MohanSai110/Multi-output-flyback-converter/README.md

# Multi-output-flyback-converter
design ,simulating and analysis of multi output flyback converter
