MohanSai110/Multi-output-flyback-converter/Final_flyback_completedesign_openloop.pdf

### Complete Design &Derivation — 150WOpen-Loop Multi-OutputFlybackConverter

12V/100W+ 5V/50W, DCM, single fixedline (230Vac mains)

Thisdocumentderiveseveryelementfromthe specificationforward,withthe reasoningat eachstep. Numbershere are thefinal, converged, self-consistent designpoint— reconcilingthe iterative refinementdone across simulation.

### 0. Specifications and starting assumptions

Parameter | Value | Basis
Output 1 | 12V, 100W(8.33A) | Given spec
Output 2 | 5V,50W(10A) | Given spec
Total Pout | 150W | Sum
Mains | 230Vac ±10%, 50Hz, | Realintendedtest condition(notuniversalinput)
| single fixed line
Operating bus | 325V (=230×√2) | Rectified peak, no-ripple idealization for the design point
Vin
Stress-rating | 90–375V | Retainedonly for component voltage margin, not for
bus range | | operatingduty —protects against line variation/spikes
| | eventhoughonlyoneline is tested
Switching | 65kHz (Ts=15.385µs) Design choice, reasonable for this power/size class
frequencyfs
Target efficiency η | ≈85–88% | Typical for a multi-output flyback this size; confirmed
| | ≈88.6%fromsimulation

1.Input stage derivation

Bridgerectifier: must handle input RMS current with margin. Estimate Iin,rms ≈ Pin/(Vac × PF); withnoPFC, PFispoor (~0.5–0.6typicalfor a capacitor-input rectifier), givingIin,rms ≈ 176.5/(230 × 0.55) ≈ 1.4Aaverage-equivalent, but peakcharging currentismuchhigher (bulkcapchargesonlynear theACpeak). Select≥4Acontinuous, 600Vrated(e.g. GBU4K) —the voltage ratingcovers the 375Vworst-case peakwith margin,the current ratingcovers the peaky, non-sinusoidal chargingcurrent.

Bulkcapacitor sizing— fromripple requirement. Discharge current between recharge peaks:

I =

Pin
=

176.5
≈ 0.59A
Vdc,avg | 300

Discharge duration= halfthe rectifiedripple period= 1/(2fline) = 1/100 = 10ms (full-bridge, 50Hzmains →100Hz ripple).

C =

IΔt
=

0.59 × 0.01
≈ 147μF → 220μF, rated 450V
bulk | ΔV | 40

(400V rated is too tight against the 375V worst-case peak; 450V gives real margin.)

Inrushlimiting: anNTCthermistor (~5Ωcold, e.g. 5D-9) inseriesbeforethebulkcap— withoutit, capinrushcanspike 50–100Amomentarilyoneverypower-up.

Surge/fuse: 275Vac MOVdirectly after the fuse; 3.15Aslow-blow fuse in series with line.

∫

### 2. Transformer turns ratioderivation(volt-secondbalance)

Core physics — why average inductor voltage must be zero over one cycle:

di(t)
vL(t) = Lp
dt

Ts
⇒ vL dt = Lp[i(Ts) − i(0)]

0

Inperiodic steadystate i(0) = i(T ), so∫
T

s
v dt = 0 —the volt-seconds appliedduring
s | 0 | L
ONmust exactly cancel those duringOFF.

DuringON, primary seesVdc directly. DuringOFF, primary sees −Vro (secondaryvoltage reflectedback, reversedbytheflyback's invertingwindingpolarity), whereVro =

n(Vout + VF ).

D
Vdc ⋅ D = Vro ⋅(1 − D) ⇒ Vro = Vdc ⋅ 1 − D

**Design-basis worst case** (for selectingthe turns ratio, worst case is *lowline*, where dutymust stretch furthest): atVdc,min = 90V , Dmax = 0.45:

V = 90 ×

0.45
= 73.6V
ro

n12 =

Vro
=
Vout12 + VF

0.55

73.6
12 + 0.7

= 5.80 (ideal target)

Physicalconstraint—actualwoundtransformer:Np = 28,Ns1 = 7turns(integer turns, achievable on the chosen core) → n12,actual = 28/7 = 4.0.

Consequence —re-solve the operatingdutycycle at the actual bus, usingthe actual n:

Vro = 4 × (12 + 0.7) = 50.8V

D =

Vro
=

50.8
= 0.1351 (→ ton ≈ 2.08μs, refined to 2.1μs in simulation) Vdc + Vro 325 + 50.8

Slave winding (5V) turns — same flux-per-turn on a shared core:

Vout12 + VF 12
=

Vout5 + VF 5 ⇒ N = 7 ×

5.5
= 3.03 → 3 turns
Ns1 | Ns2
s2 | 12.7

n5 = 28/3 = 9.333

### 3. Operatingpoint — self-consistent solve (DCM, confirmedfromsimulation)

Mode determination (measured, not assumed): the primary current waveform shows a flat zero-current dwell eachcycle—theunambiguous DCMsignature. This is the foundational factthe rest ofthe derivationdependson(see §9forwhy).

DCMpower balance (derived fully in §9 below; stated here for the design-point solve):

Pout = η ⋅

1LpI

2
fs
2 peak

At the converged operating point (Vin=325V, ton=2.1µs, D=0.1365):

I =

Vin ⋅ ton
=

325 × 2.1μs
≈ 4.55A (idealized)
peak | Lp | 150μH

Note on the gap between idealized and measured Ipeak (5.93A): the idealized single-equivalent-inductor formulaaboveunder-predictsthereal simulatedpeakbecausethereal transformer has two secondaries with different individual inductances (Ls1≠Ls2), which draws more real energy transfer thana single-secondary idealization captures —this is the same effect responsible for the 5Vrail'soutsizedcurrent spike (§6). Usethemeasured

rms

2

value,Ipeak≈5.93A,forall downstreamstress calculations —it is the more trustworthy number for this specific transformer.

B =

LpIpeak
=

150μH × 5.93
= 86.3mT ≪ 390mT (N87 saturation limit)—safe, healthy margin
max | NpAe | 28 × 368mm²
Ipri,rms = | (DCM triangular,Ibase = 0) ≈ 1.59A

### 4. MOSFETderivation

Voltage stress:

Vds,max = Vdc,max + Vclamp

Using the stress-rating bus (375V, §0) plus the designed snubber clamp (§5, 130V target):

Vds,max ≈ 375 + 130 = 505V (simulation showed 472–530V depending on run — see §5 note)

Required rating: for 80% derating guideline, Vds,max/0.8 ≥ 505/0.8 = 631V minimum →
select 700V class, not 600–650V, given the simulated spread reached as high as 530V on its
own.

Current rating: Ipeak≈5.93–6.3A (allow margin for line/load variation), Irms≈1.6A. Select Id,cont≥10A,RDS(on)≤0.4–0.5Ω.

Loss estimate:

Pcond = I

2 × RDS(on) = 1.6² × 0.45 ≈ 1.15W

Psw ≈ 1VdsIpeak(tr + tf)fs ≈ 0.5 × 400 × 6 × 100ns × 65000 ≈ 7.8W (dominant loss term — requires heatsinking)

### 5. Primary RCD snubber derivation

Purpose: clampthevoltage spikefromprimaryleakageinductance (Llk) discharginginto parasitic capacitance atturn-off.

Leakage energy per cycle:

Elk =

1LlkI

2

2 peak

UsinganassumedLlk = 1.5μH (≈1%ofLp—mustbeconfirmedbymeasurementon thewoundtransformer, shortingall secondaries andmeasuringprimaryL):

Elk = 0.5 × 1.5μH × 5.93² = 26.4μJ ⇒ Pleakage = Elkfs ≈ 1.72W

Clampvoltage choice —sizedagainst the MOSFET's real margin, not arbitrarily: target Vclamp = 130V (keepsVds,max ≈ 505V , withinthe 700Vdevice's safe marginfrom§4).

Snubber resistor:

P | = P | ×

Vclamp
= 1.72 ×

130
= 2.83W → 5.6kΩ, 5–8W
Rsnub | leakage | Vclamp − Vro | 130 − 50.8

Snubbercapacitor (sizedfor τ = RC ≫ Ts,~10×):

Csnub =

10Ts

Rsnub

=

10 × 15.385μs
≈ 27.5nF → 33nF, rated ≥600V 5600

3

D ⋅

peak

Snubber diode: ultrafast recovery (<100ns), VR≥600V— e.g. UF4007/UF5408. Not a standard1N4007(tooslow, adds switchingloss).

Noteonobservedvs. designedclamp: simulationshowedVds spikes ranging472–530V acrossdifferent runs—somewhat above the 505Vdesigntarget, meaningthe real clamp achievedwas closer to150–200Vrather thanthedesigned130V. Thisgapis expecteduntil therealleakageinductanceismeasuredandRsnub/Csnubretunedagainstthe actual(not assumed) value—treatthe values above as a startingpoint requiringbenchiteration, not a final tuned result.

### 6. Secondary rectifier andsnubber derivation, both rails

Reverse voltage stress (using stress-rating bus, 375V):

V | = V | +

Vdc,max
= 12 +

375
= 105.8V → 200V rated Schottky (MBR20200CT)
R,12V | out12
n12 | 4
V | = V | +

Vdc,max
= 5 + 375 = 45.2V → 100V rated Schottky (MBR20100CT), extra margin over
R,5V | out5
n5 | 9.333

Peakcurrent, using the correct (non-inverted) power-split formula:

I | = I | × n ×

Pout,i

sec,i,peak | peak | i
Pout,total

100
Isec1,peak = 5.93 × 4 ×

150 = 15.8A (simulation confirmed ≈16.7–17.1A, close agreement)

Isec2,peak = 5.93 × 9.333 ×

50
150 = 18.5A (idealized) — simulation consistently showed 30–34A instead

Why the 5Vrail's real peakexceeds the idealizedformula—this is agenuine physical effect,notamodelingerror:thetwosecondarieshaveverydifferent self-inductances ( Ls1 = 9.375μH vsLs2 = 1.722μH). Atthe instant ofswitch turn-off, instantaneous ampere-turnbalance across allthree windings must hold simultaneously—the low-inductancewinding(5V) satisfiesthiswithaproportionallysharper, higher current spike thanthe power-ratio approximationpredicts, eventhoughits average delivered current stayscorrect(~10A,matchingspec).Designconclusion: ratethe5Vrectifierfor≥40A peakcapability, notthe idealized~18–20A.

Output capacitor sizing (ripple-based):

ΔV =

IoutD
charge Coutfs

SolvingforCout at a target ripple (12Vrail,target ≈150mV):

C ≈

8.33 × 0.1365
≈ 11,650μF → 13,200μF (4×3300µF) selected, gives margin
out,12V
0.150 × 65000

Same method, 5Vrail, target ≈90mV: → 17,600µF(8×2200µF).

ESRcontributiontototal ripple:

ΔVESR = Isec,peak × ESRbank

Bank ESRfromparallel individual-cap ESR(~36mΩ each): 12Vbank (4 parallel) → 9mΩ; 5Vbank(8parallel) →4.5mΩ.

Ripple current rating check(AC component only, subtracting DC):

Iripple =

3.0A total → 0.38A/cap (comfortable).

SecondaryRCsnubbers(dampingtheturn-onringingbetweenleakageinductanceand diode junction capacitance —required, confirmedbythe 30A+ peak/ringingbehavior foundinsimulation): 12Vrail:33–47Ω +2.2–3.3nFacrossD1. 5Vrail(needs stronger damping, given the larger spike): 22–33Ω + 3.3–4.7nF across D2. Tune empirically against the real ringingfrequencyonce benchwaveforms are available.

High-frequencydecoupling(missing from a pure electrolytic-only filter): add 1–2.2µF X7Rceramicat eachoutput terminal, in parallel withthe electrolyticbank.

### 7. Parasiticelement summary(everythingfoldedinabove, collectedinone

place)

Element | Value | Where derived
Primary leakage | 1.5µH (assumed, ~1% of | §5 — must be measured on the real
inductance, Llk | Lp) | transformer
Inter-secondary coupling | 0.995 (assumed) | Consistent with Llk assumption
MOSFETRDS(on) | 0.45–0.5Ω | §4
Output capESR,12Vbank | 9mΩ | §6
Output capESR, 5Vbank | 4.5mΩ | §6
Current-sense resistor R1 | 0.47Ω | Fixed hardware choice (current-mode
| | control)
Diodeforwarddrop,12V | ≈0.7–0.9V (200V-class | §6
rail | Schottky)
Diode forwarddrop, 5Vrail | ≈0.5–0.7V (100V-class | §6
| Schottky)
Snubber diode recovery | <100ns (ultrafast) | §5

time

### 8. Winding construction (wire/foil spec, from RMS current + skin depth)

Skindepthat 65kHz,100°C: δ ≈ 0.29mm—single conductor strandsmust staywell below2δ.

Winding | Turns RMS current

Construction

Primary | 28 | ~1.6A | 60×0.1mm(AWG38) Litz, served/twisted(~0.47mm²
| | | copper, ~3.4A/mm²)
Secondary 1 (12V) | 7 | ~9.0A | 0.1mm× 25mmcopper foil, interleavedwith
| | | polyimide/mylar tape
Secondary 2 (5V) | 3 | ~10.5A | 0.1–0.12mm × 25mmcopper foil, same interleaving

Recommended winding order (P–S1–S2–P sandwich) to minimize leakage inductance directly, rather thanrelyingentirelyonthe snubber to absorbit.

### 9. Final Bill of Materials

Item | Spec | Notes
Bridge rectifier | 4A,600V | §1

NTC inrush limiter | ~5Ω cold | §1
Bulk capacitor | 220µF, 450V | §1
MOV | 275Vac | §1
Fuse | 3.15A slow-blow | §1
Transformer core | ETD59, N87, gapped for Lp=150µH | §2
Primary winding | 28t, 60×0.1mm Litz | §8
Secondary 1 (12V) | 7t, 0.1×25mm foil | §8
Secondary2 (5V) | 3t, 0.1–0.12×25mm foil | §8
MOSFET | 700Vclass, ≥10A, RDS(on)≤0.5Ω | §4
Primary snubber | R=5.6kΩ (5-8W), C=33nF/600V, ultrafast diode | §5—retuneonceLlkis measured
Rectifier D1 (12V) | 200V Schottky, ≥25-30A (MBR20200CT | §6
| class)
Rectifier D2 (5V) | 100VSchottky, ≥40Acapability | §6
Secondary snubber, 12V | 33-47Ω + 2.2-3.3nF | §6
Secondary snubber, | 22-33Ω + 3.3-4.7nF | §6
5V
Output capbank,12V | 4×3300µF (13,200µF), 25V rated | §6
Output capbank,5V | 8×2200µF (17,600µF), 10V rated | §6
Output decoupling | 1-2.2µF X7R ceramic, both rails | §6
Current-sense resistor | R1=0.47Ω | Primary, MOSFET source

Remainingbench-verificationitems beforethis is consideredfinal: measure real Llk and retune bothsnubbers against it; confirmactual switchingfrequency/duty at the real bus voltage; verifythe5Vrail's real peakcurrent againstthe≥40Adiodemarginunder load.
