MohanSai110/Multi-output-flyback-converter/final_open_loop.asc

C1: cap; 33n; Rser=0.1
C2: cap; 13200µ; Rser=0.009
C3: cap; 17600µ; Rser=0.0045
C4: cap; 150p
C5: cap; 2.2n
C6: cap; 3.3n
D1: diode; MUR460
D2: diode; D2
D3: diode; D3
L1: ind; 150µ; Rser=0.082
L2: ind; 9.375µ; Rser=0.015
L3: ind; 1.722µ; Rser=0.005
Llk: ind; 1.5µ; Rser=1m
M1: nmos; AOD280A60
R1: res; 0.47
R2: res; 5.6k
R3: res; 33
R4: res; 22
Rload5: res; 0.5
Rload12: res; 1.44
V2: voltage; PULSE(0 12 0 20n 20n 2.1u 15.38u)
Vdc: voltage; 325
Named nets: 0, Vout12, Vout5, Vdc, Vdrain
.model D1 D(Is=15n Rs=0.05 N=1.6 Cjo=40p M=0.33 Vj=0.6 Bv=600 Ibv=10u Tt=25n)
 
.model D2 D(Is=5u Rs=0.012 N=1.05 Cjo=350p M=0.4 Vj=0.45 Bv=200 Ibv=50u Tt=0)
 
.model D3 D(Is=8u Rs=0.015 N=1.02 Cjo=220p M=0.38 Vj=0.4 Bv=60 Ibv=100u Tt=0)
K1 L1 L2 L3 0.995
.tran 0 20m 
.meas Vout12 avg V(Vout12) FROM 18m TO 20m
.meas Vout5 avg V(Vout5) FROM 18m TO 20m
.meas Iout12 avg I(Rload12) FROM 18m TO 20m
.meas Iout5 avg I(Rload5) FROM 18m TO 20m
.meas Pin avg V(Vdc)*I(Vdc) FROM 18m TO 20m
.meas Pout12 avg V(Vout12)*I(Rload12) FROM 18m TO 20m
.meas Pout5 avg V(Vout5)*I(Rload5) FROM 18m TO 20m
.meas Efficiency param (Pout12+Pout5)/(-Pin)*100
.meas Vds_max max V(Vdrain) FROM 18m TO 20m
.meas Ipri_peak min I(L1) FROM 18m TO 20m
.meas Ipri_rms rms I(L1) FROM 18m TO 20m
.meas TRAN Sec1_Peak_Current MAX I(D2) FROM 0.018 TO 0.02
.meas TRAN Sec2_Peak_Current MAX I(D3) FROM 0.018 TO 0.02
