MohanSai110/Multi-output-flyback-converter/smallsignal_averaged.asc

B1: bi; I = (0.5 * {eta} * {fs} * {Lm} * (V(vcomp) / {Rs})**2) / V(Vin)
B2: bi; I=(0.5 * {eta} * {fs} * {Lm} * (V(vcomp) / {Rs})**2) / (V(OUT) + 1m)
C1: cap; 150p
Cout: cap; 13200µ; Rser=9m
Rload: res; 1.44
V1: voltage; 325
V2: voltage; 2.27; AC 1
Named nets: 0, vcomp, OUT, Vin
.param fs=65k Lm=150u Rs=0.47 eta=0.886
.op
.ac dec 100 1 100k
.ac dec 200 1 100k
.meas AC DCgain FIND mag(V(OUT)) AT=1
.meas AC Gain10Hz FIND mag(V(OUT)) AT=10
.meas AC Gain20Hz FIND mag(V(OUT)) AT=20
.meas AC Gain30Hz FIND mag(V(OUT)) AT=30
*phase(V(OUT))
